KizEvo/BuddyArm/Hardware/buddy_arm.FCStd

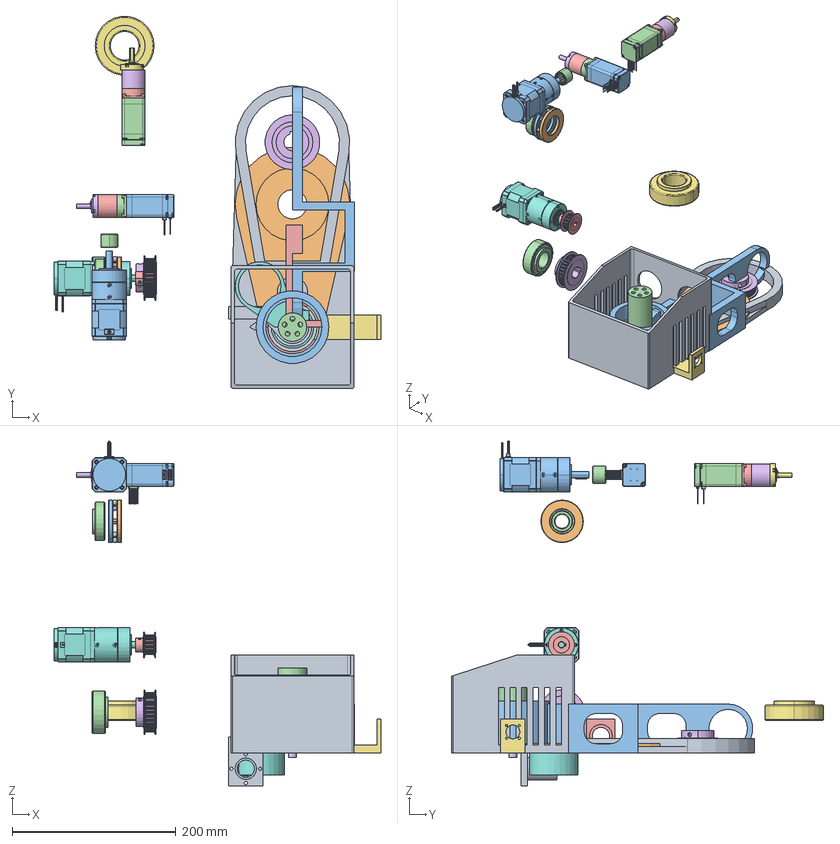
[picture p1: CAD file, 2026-10-26]
Hardware/buddy_arm.FCStd
399.1 x 454.4 x 421.2 mm
Base
J1_Base
J1_Turret_Housing
J1_Spindle
J1_Platform
CBTB-AN1-XL037-38-B-N-dh21
BCUQ-32207
J2_Turret_Housing
J2_Tension_Ring
J2_Spindle
J2_Arm
BCUQ-32205
CBTB-AN1-XL037-15-B-N-d8
CBTB-AN1-XL037-30-B-N-d18
17HS15-1684D-HG50-AR4
17HS15-1684D-HG50-AR001
J4_Turret_Housing
J4_Spindle
17HS15-1684D-HG10-AR4
BCWF-K-HK1516
J5_Arm
J5_Spindle
11HS20-0674D-EGS16-AR4
11HS20-0674D-EGS16-AR001
11HS20-0674D-EGS16-AR002
11HS20-0674D-EGS16-AR003
11HS20-0674D-EGS16-AR004
11HS20-0674D-EGS16-AR005
11HS20-0674D-EGS16-AR006
11HS20-0674D-EGS16-AR007
J6_Arm
11HS20-0674D-EGS16-AR009
11HS20-0674D-EGS16-AR010
11HS20-0674D-EGS16-AR011
11HS20-0674D-EGS16-AR012
11HS20-0674D-EGS16-AR013
11HS20-0674D-EGS16-AR014
11HS20-0674D-EGS16-AR015
11HS20-0674D-EGS16-AR016
J3_Bearing_Cup
J3_Spindle
BCUQ-30303
