KizEvo/BuddyArm/Hardware/CAD/buddy_arm-J2_Spindle.stl

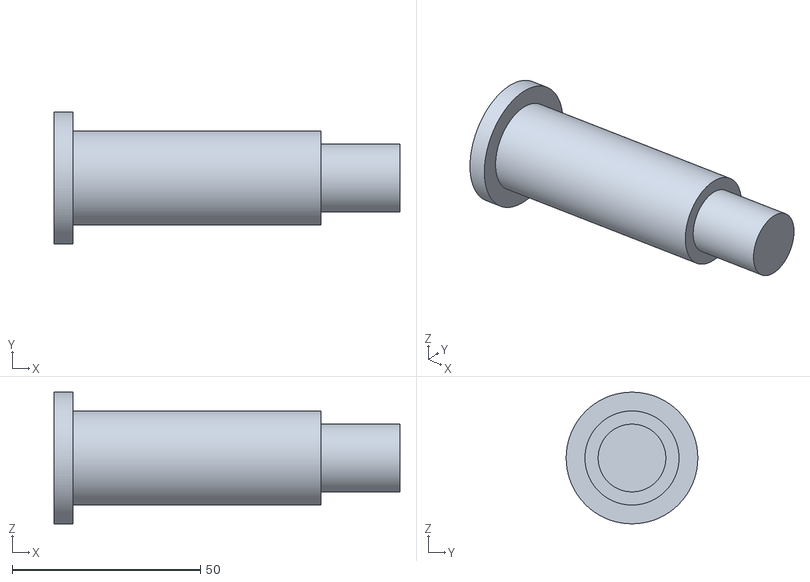
[picture p2: CAD file, 2026-10-26]
Hardware/CAD/buddy_arm-J2_Spindle.stl
92.0 x 35.0 x 35.0
