KizEvo/BuddyArm/Hardware/CAD/buddy_arm-J2_Tension_Ring.stl

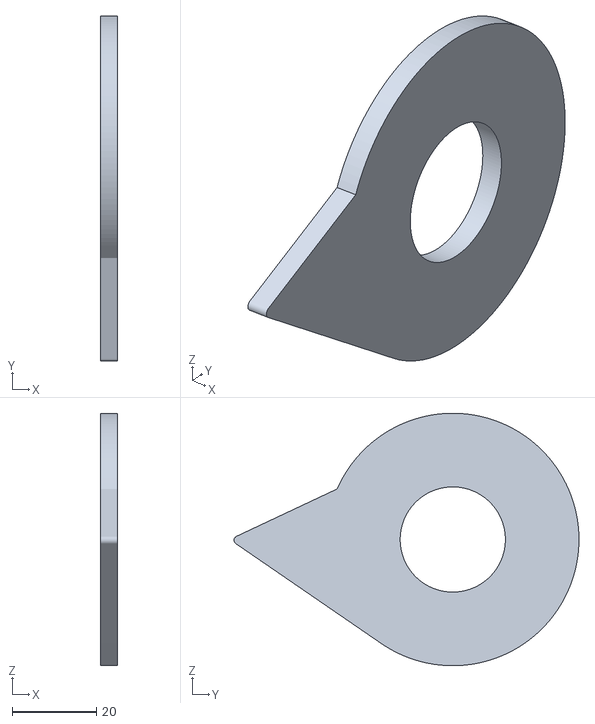
[picture p3: CAD file, 2026-10-26]
Hardware/CAD/buddy_arm-J2_Tension_Ring.stl
4.00 x 82.0 x 60.0
