KizEvo/BuddyArm/Hardware/CAD/buddy_arm-J1_Platform.stl

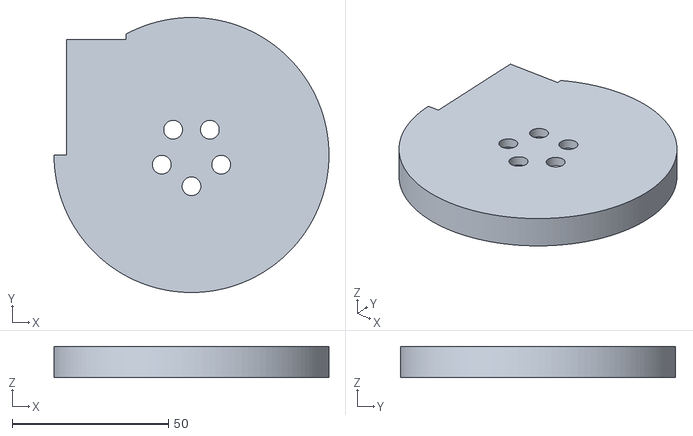
[picture p4: CAD file, 2026-10-26]
Hardware/CAD/buddy_arm-J1_Platform.stl
88.0 x 88.0 x 10.0
