KizEvo/BuddyArm/Hardware/CAD/buddy_arm-J4_Turret_Housing.stl

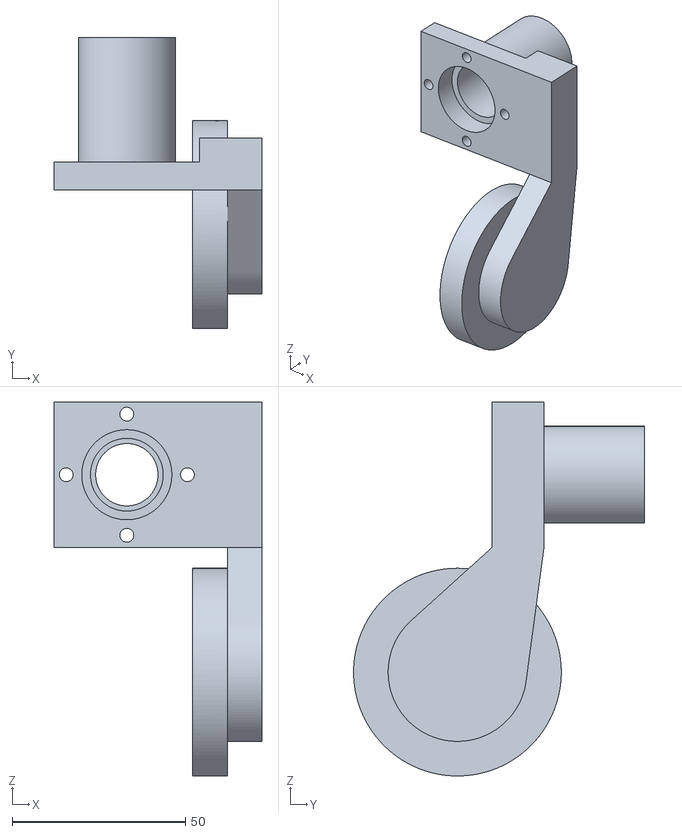
[picture p5: CAD file, 2026-10-26]
Hardware/CAD/buddy_arm-J4_Turret_Housing.stl
60.0 x 84.0 x 108.0
