KizEvo/BuddyArm/Hardware/CAD/buddy_arm-J1_Spindle.stl

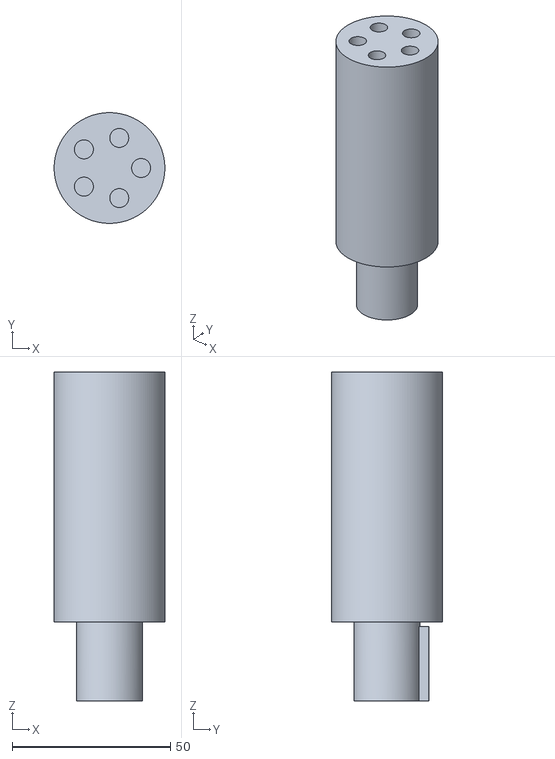
[picture p6: CAD file, 2026-10-26]
Hardware/CAD/buddy_arm-J1_Spindle.stl
35.0 x 35.0 x 104.0
