KizEvo/BuddyArm/Hardware/CAD/buddy_arm-J5_Arm.stl

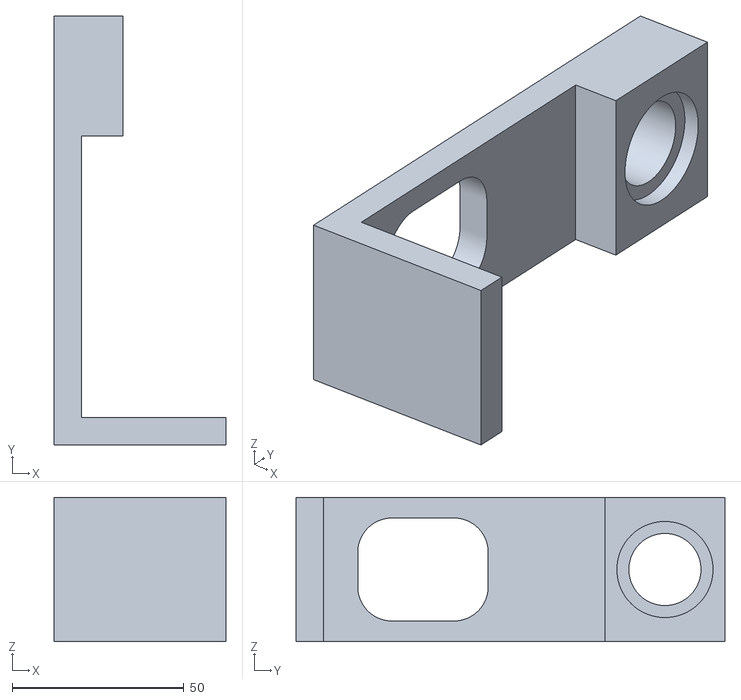
[picture p7: CAD file, 2026-10-26]
Hardware/CAD/buddy_arm-J5_Arm.stl
50.0 x 125.0 x 42.0
