KizEvo/BuddyArm/Hardware/CAD/buddy_arm-J4_Spindle.stl

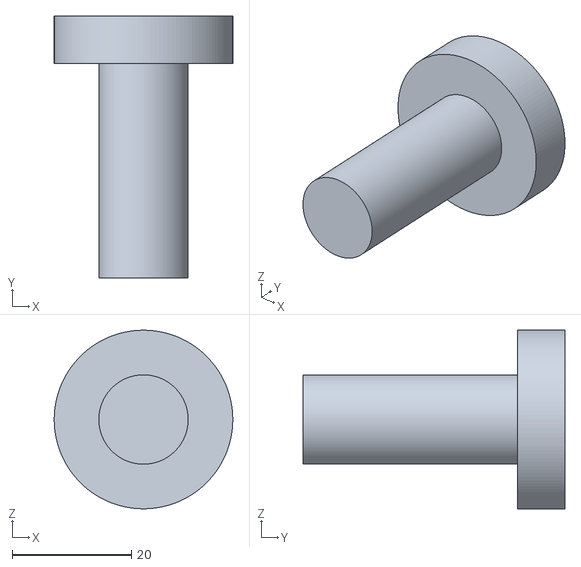
[picture p8: CAD file, 2026-10-26]
Hardware/CAD/buddy_arm-J4_Spindle.stl
30.0 x 44.0 x 30.0
