KizEvo/BuddyArm/(commit log)

2026-09-20 Hardware: Firmware: add initial hw and fw files
    Hw: CAD files for robot arm - WIP.
    Fw: README for now.
    [my_robot_arm.FCStd]
2026-09-20 Hardware: import files and update J1 cover plate
    Import tapered roller bearing, 60T XL pulley.
    Update holes for J1 cover plate. This is where J1 spindle
    attach to the 60T pulley.
    [my_robot_arm.FCStd]
2026-09-20 Hardware: add J1 components and update pulley bearing
    Add J1 turret housing. Modeling around 32207 bearing spec.
    Use to CBTB-AN1-XL037-38-B-N-d21 pulley. Why ? parts that house this
    component need precise fit/tolerance/clearance. We cannot do that with
    60T XL pulley. As it can't be measured in FreeCAD => No TechDraw.
    Use 32207 bearing. As it's better fit to support the whole robot arm,
    coming in with 67.6 kN (dyn load) and 84.3 kN (static load). Likely a
    (very) safe margin for this project.
    [my_robot_arm.FCStd]
2026-09-20 Hardware: add J1 spindle and fix J1 turret housing
    Add J1 spindle part
    Fix J1 turret housing: it now has depth of 24.5 mm each side.
    Depth doesn't need as much precision as hole diameter of 72mm.
    Also arrange the parts to see if they fit "visually", actual
    assembly is done later.
    [my_robot_arm.FCStd]
2026-09-22 Hardware: update J1 spindle and add J1 platform
    Update J1 spindle keyway to hold pulley.
    Add J1 platform.
    [my_robot_arm.FCStd]
2026-09-23 Hardware: update J2 turret housing and fix J1 platform
    Update J2 turret housing.
    Fix J1 platform, we should connect J2 turret from the side,
    instead of front. So remove front hole
    [my_robot_arm.FCStd]
2026-09-25 Hardware: update J1 platform and J2 turret housing
    Add holes and carve out the front for J2 turret.
    Update J2 turret housing to hold tapered bearings (32205).
    Also import 32205 tapered bearing.
    [my_robot_arm.FCStd]
2026-09-26 Hardware: add J2 stepper motor and pulleys
    [my_robot_arm.FCStd]
2026-09-28 Hardware: update J1 platform, update J2 parts
    Remove chamber design of J1 platform. Also carve a pocket
    for J2 motor housing.
    Add initial J2 motor housing.
    [my_robot_arm.FCStd]
2026-09-29 Hardware: update J1 platform and J2 motor housing
    Flatten the J1 platform edge for J2 motor housing.
    [my_robot_arm.FCStd]
2026-09-29 Hardware: update J2 parts
    Add J2 tension ring. This part help turn off the mechanical switch
    during zero point calibration.
    Finish initial design for J2 motor base (renamed from J2 motor housing)
    and J2 turret housing.
    With this J2 motor base design. We need to update J1 base later, as J2
    motor base would hit the J1 motor during rotation.
    [my_robot_arm.FCStd]
2026-09-29 Hardware: add J2 spindle and update J2 tension ring
    Add initial design for J2 spindle. Need to add keyway later.
    Carve a hole in J2 tension ring so that J2 spindle can go
    through.
    [my_robot_arm.FCStd]
2026-09-30 Hardware: add J2 arm and update J2 spindle
    Add inital design for J2 arm.
    Update J2 spindle shaft to align with J2 arm.
    [my_robot_arm.FCStd]
2026-09-30 Hardware: change J2 arm design, J1 platform
    Remove J2 motor base with the new J2 arm design. We'll attach
    the motor directly in the J2 arm. This lead to the removal of
    the J1 platform motor mount (J2 motor).
    [my_robot_arm.FCStd]
2026-09-30 Hardware: add J3 bearing cup
    [my_robot_arm.FCStd]
2026-10-02 Hardware: add J3 spindle J4 turret housing and bearings
    Currently J4 turret housing rotation is limited by J3 motor.
    We have small space. Need to fix J4 turret housing.
    [my_robot_arm.FCStd]
2026-10-02 Hardware: change J4 turret housing design and add J4 spindle
    Change J4 turret design. New design allow 180 deg rotation
    around J3.
    Add initial design for J4 spindle.
    [my_robot_arm.FCStd]
2026-10-03 Hardware: add J5 arm and spindle
    Add initial design for J5 arm and J5 spindle.
    J5 motor use 11HS20-0674D-EGS16-AR4 stepper motor.
    [my_robot_arm.FCStd]
2026-10-03 Hardware: add J6 arm and stepper motor
    Add J6 arm initial design and stepper motor.
    [my_robot_arm.FCStd]
2026-10-26 Hardware/CAD: export initial design .stl for URDF test
2026-10-26 Simulation/ros2: add skeleton URDF ros2 package
    CMakeList: add src/* to install command
    LICENSE: use BSD-3-Clause
    display.launch.py: use ros2 URDF tutorial launch script. Modify filenames.
    src/*: use ros2 URDF tutorial for URDF and RViz files.
    package.xml: add 'urdf_launch' package dependency - require installing
    via package manager.
2026-10-26 Simulation/ros2: use Xacro extension instead of URDF
    Xacro allow XML macro language used as a preprocessor to
    generate clean URDF.
2026-10-26 Simulation/ros2: add CAD meshes to URDF
2026-10-26 Simulation/ros2: update new mesh files with default origin
    Previous mesh files (.dae) contain origin with some offset value.
    This make it hard to apply rotation and translation in URDF.
    This commit fix that by generating new mesh files from FreeCAD.
2026-10-26 Simulation/ros2: update URDF to display J1 parts
    Update URDF MCU base and J1 links.
    The joint element describes the kinematics and dynamics of the joint.
    The current origin element in joint is derived from FreeCAD assembly
    workbench where it list detail about the desired xyz.
2026-10-26 Simulation/ros2: add J2 parts in URDF
2026-10-26 Simulation/ros2: add J3 parts in URDF
2026-10-26 Simulation/ros2: add J4 parts in URDF
2026-10-26 Simulation/ros2: add J5 parts in URDF
2026-10-26 Simulation/ros2: add J6 part in URDF
2026-10-26 Simulation/ros2: add helper script to calc URDF origin
    Convert existing FreeCAD assembly coordinates into proper URDF
    kinematic tree. The script accept XYZ in mm and degree.
    The script is built around these formulas:
    Translation:
    Pjoint = Transpose(Rparent) * (Pchild - Pparent)
    Rotation:
    Rjoint = Tranpose(Rparent) * Rchild
    Then, convert Rjoint to Roll,Pitch,Yaw - RPY:
    Rjoint = Rz(yaw)Ry(pitch)Rz(roll)
2026-10-26 Simulation/ros2: fix URDF kinematic tree
    Currently every joint has mcu_base_link as its parent.
    This is incorrect, as this means the J2 arm is attached directly to
    the base, not to the J1 rotating assembly. When we change the J1 angle
    the J2 arm will not follow it.
    Simplified tree:
    MCU_Base_Link
    |
    J1 - revolute
    |
    J2 - revolute
    |
    J3 - revolute
    |
    J4 - J5 - J6 - EndEffector
    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
2026-10-26 Simulation/ros2: update spindle joints to revolute type
    Add axis and limit element for spindle joints.
    Update joint type to revolute.
    For now, the velocity and effort tag act as placeholder, as these
    two tags are required for revolute joint. We're likely to update
    this when experimenting with physics.
2026-10-26 Simulation/ros2: update RViz configuration file
    Display TF frames of revolute joint only (spindle).
2026-10-26 Simulation/ros2: add J6 motor mesh to ros2 package
2026-10-26 Simulation/ros2: add J6 motor and dummy end-effector in URDF
2026-10-26 Simulation/ros2: add collision tag to links
    Use simple box geometry as collision model.
    Help reduce computation time.
    End-effectir use cylinder geometry.
2026-10-26 Simulation/ros2: refactor robot URDF file
    Move joint parts that make up a link into a single
    <link> element. <link> element support multiple <visual> element.
    Remove redundant links, cleanup <joint> description and <collision>.
    We only have 6 joints now.
2026-10-26 Simulation/ros2: generate ros2 moveit package
    'buddyarm_moveit' package was generated by 'moveit_setup_assistant'.
    Also fix demo bugs in generated package
    - moveit_controllers.yaml: add 'action_ns' and 'default'
    - joint_limits.yaml: change max_velocity to double number (1.0)
    instead of integer number (1), set has_acceleration_limits
    and max_acceleration to double number too.
    Why there is bugs in auto generated file you may ask ?
    I don't know. Perhaps ros2 is not complicated enough.
2026-11-13 Simulation/ros2: add inertia to robot URDF
    Add <inertia> tag to links with mass, origin and moment of inertia.
    Use the FCInfo.FCMacro by mario52 in FreeCAD to obtain link parts
    mass and moment of inertia.
    <inertia> tag origin is relative to the link origin. To get the
    inertia origin, first in Part FreeCAD workbench we use the Compound
    feature to merge parts that belong to a link. That compounded parts
    give us the mass, moment of inertia and center of mass (CoM).
    Then we add CoM origin (child) and spindle origin (parent) to the
    freecad_to_urdf.py helper script to get the <inertia> origin.
